soft79/atari-keyboard/Documents/Pokey keyboard connections.png

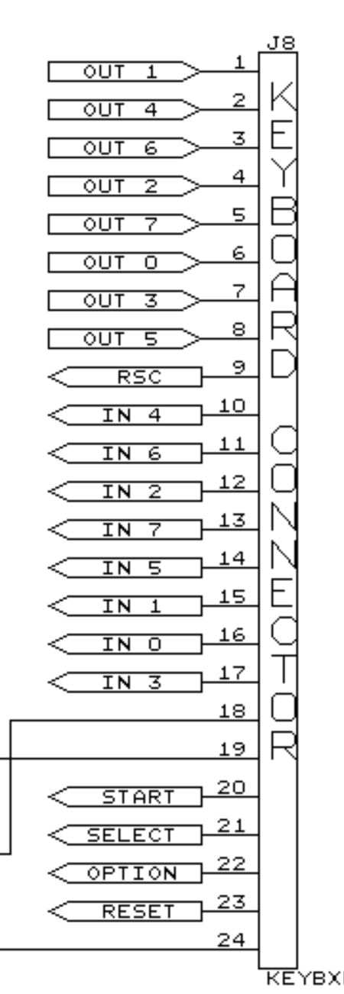
Documents/Pokey keyboard connections.png
