soft79/atari-keyboard/(commit log)

2021-11-10 Support CLEAR / INSERT keys
2021-11-10 Include keyboard matrix schematic
2021-11-11 Fix: missing check for #ifdef DEBUG_SERIAL
    [atari-keyboard.ino]
